dotcypress/cereal/docs/schematics.pdf

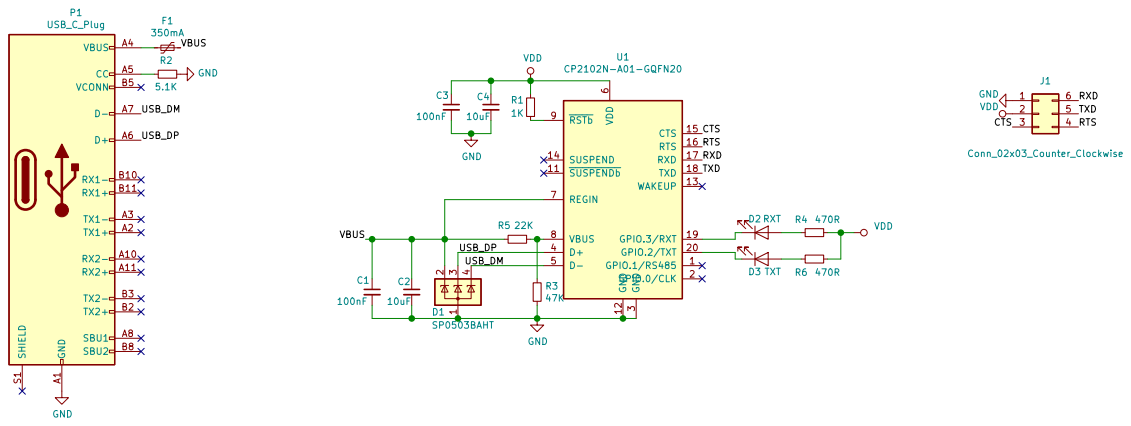
[picture p3: page 1]

6 REGIN 7 VBUS 8 RSTb 9 U1 CP2102N-A01-GQFN20 R5 22K GND GND
