dotcypress/cereal/cereal.kicad_pcb

## KiCad design cereal.kicad_pcb (2020-09-15)

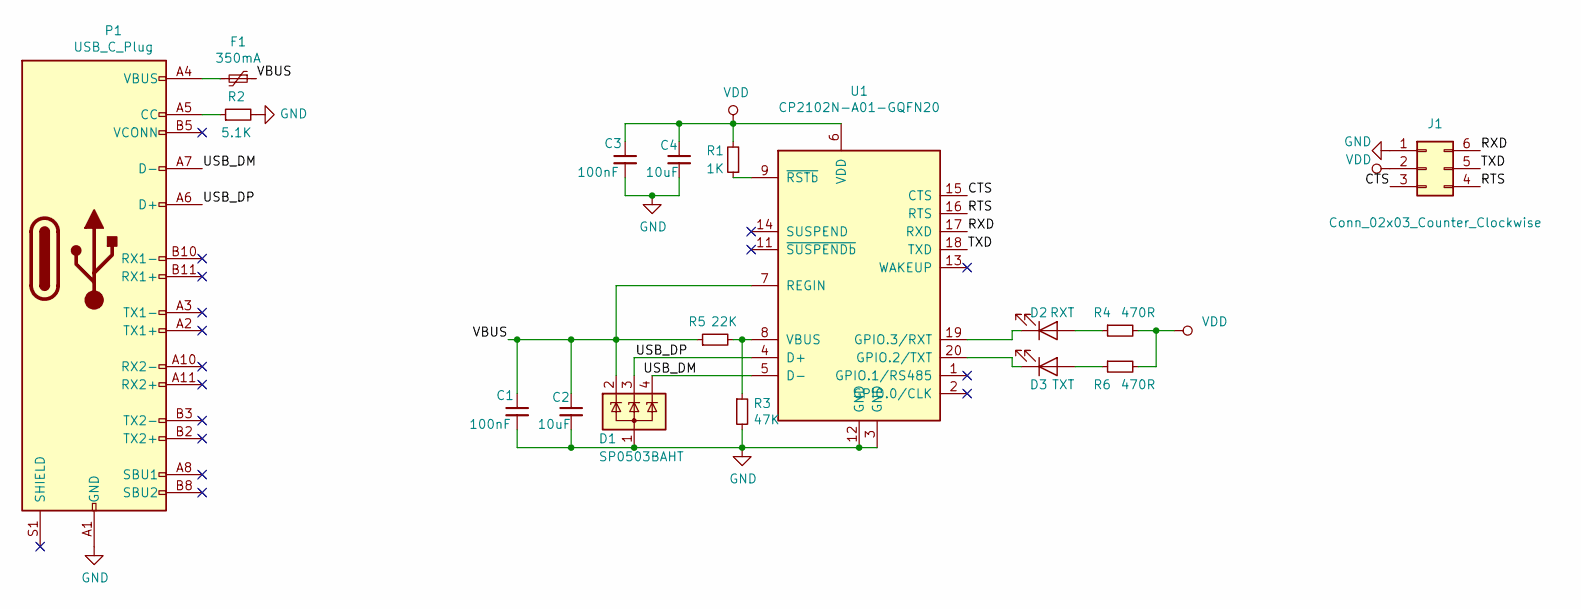
[picture p4: schematic cereal.sch]

Parts:
C1, C3: 100nF; C_0603_1608Metric
C2, C4: 10uF; C_0603_1608Metric
D1: SP0503BAHT; SOT-143
D2: RXT; LED_0603_1608Metric
D3: TXT; LED_0603_1608Metric
F1: 350mA; Fuse_0603_1608Metric
J1: Conn_02x03_Counter_Clockwise; PinHeader_2x03_P2.00mm_Vertical
P1: USB_C_Plug; USB_C_Plug_HRS_CX60-24S-UNIT
R1: 1K; R_0603_1608Metric
R2: 5.1K; R_0603_1608Metric
R3: 47K; R_0603_1608Metric
R4, R6: 470R; R_0603_1608Metric
R5: 22K; R_0603_1608Metric
U1: CP2102N-A01-GQFN20; SiliconLabs_QFN-20-1EP_3x3mm_P0.5mm

Connections:
/CTS: J1.3, U1.15 (CTS)
/RTS: J1.4, U1.16 (RTS)
/RXD: J1.6, U1.17 (RXD)
/TXD: J1.5, U1.18 (TXD)
/USB_DM: D1.4 (K), P1.A7 (D-), U1.5 (D-)
/USB_DP: D1.3 (K), P1.A6 (D+), U1.4 (D+)
/VBUS: C1.1, C2.1, D1.2 (K), F1.1, R5.1, U1.7 (REGIN)
GND: C1.2, C2.2, C3.2, C4.2, D1.1 (A), J1.1, P1.A1 (GND), P1.A12 (GND), P1.B1 (GND), P1.B12 (GND), R2.2, R3.2, U1.3 (GND), U1.12 (GND)
unnamed: D2.1 (K), U1.19 (GPIO.3/RXT)
unnamed: D2.2 (A), R4.1
unnamed: D3.1 (K), U1.20 (GPIO.2/TXT)
unnamed: D3.2 (A), R6.1
unnamed: F1.2, P1.A4 (VBUS), P1.A9 (VBUS), P1.B4 (VBUS), P1.B9 (VBUS)
unnamed: P1.A5 (CC), R2.1
unnamed: R1.1, U1.9 (~RSTb)
unnamed: R3.1, R5.2, U1.8 (VBUS)
VDD: C3.1, C4.1, J1.2, R1.2, R4.2, R6.2, U1.6 (VDD)

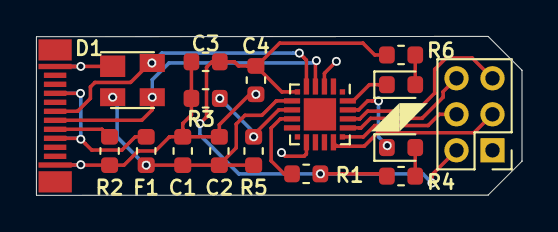
[picture p5: board cereal.kicad_pcb from above]

Board: 2 copper layers, 27.0 x 8.8 mm, 17 parts (0 on the bottom side), 17 nets.
